k0swe/hs100b-eval/README.md

Evaluation board for the CMedia HS100B USB audio controller.
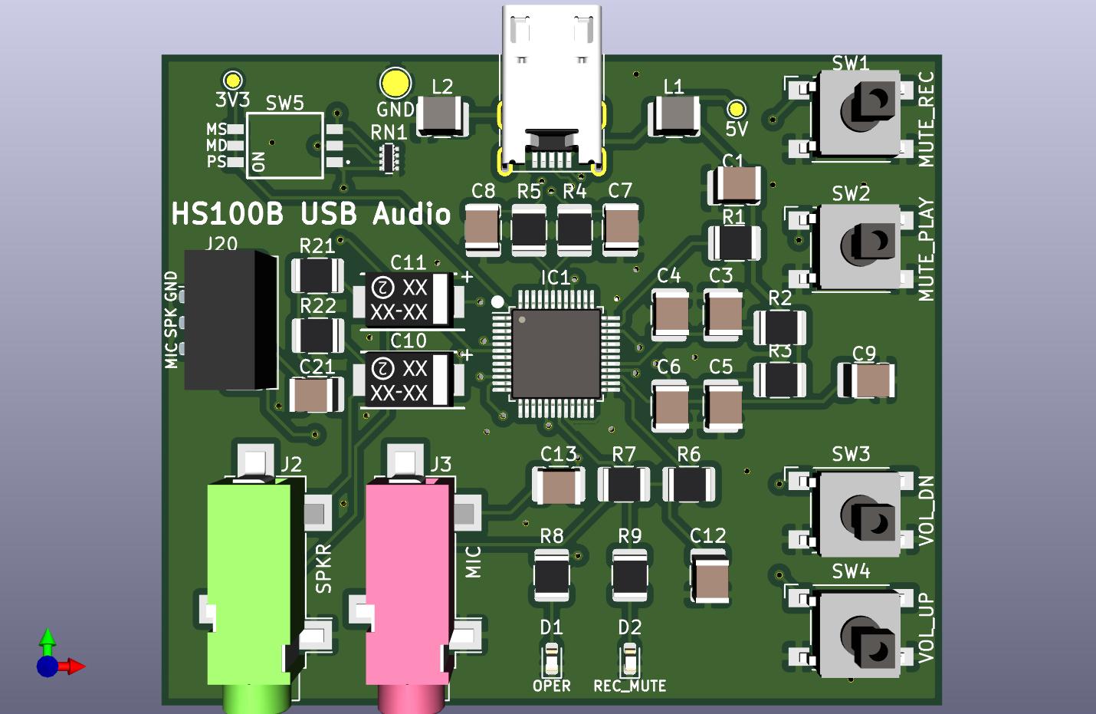
[picture p1: render.jpg]
Render
