k0swe/hs100b-eval/hs100b-eval.pdf

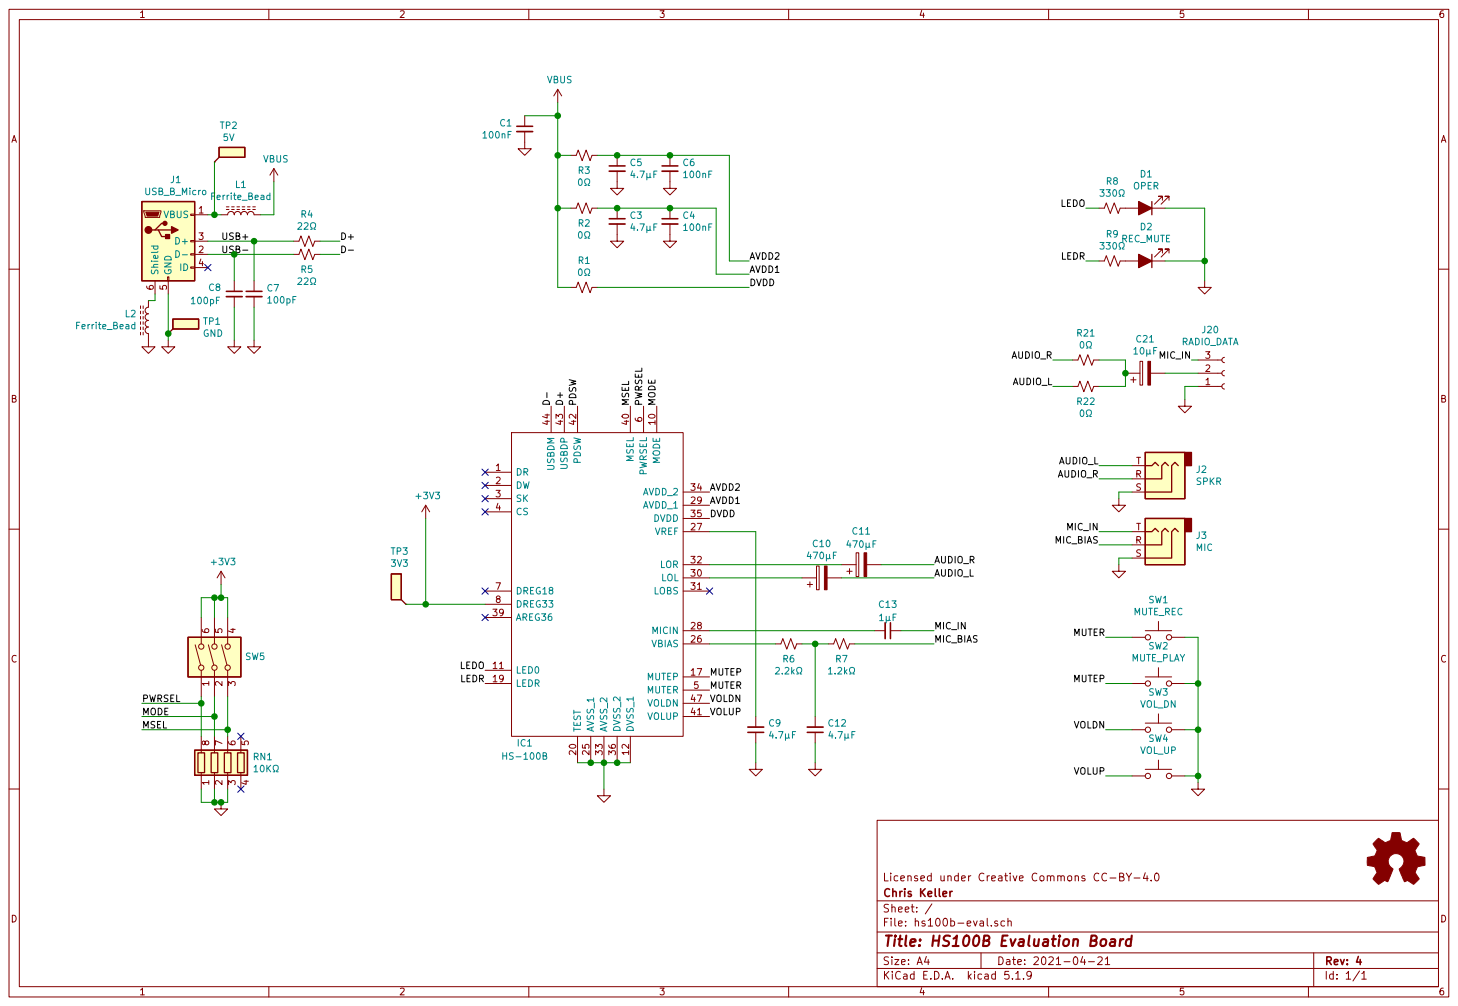
[picture p2: page 1]

File: hs100b-eval.sch Sheet: / Chris Keller Licensed under Creative Commons CC-BY-4.0 C12

Id: 1/1 Title: HS100B Evaluation Board
