k0swe/hs100b-eval/hs100b-eval.kicad_pcb

## KiCad design hs100b-eval.kicad_pcb (2021-04-24)

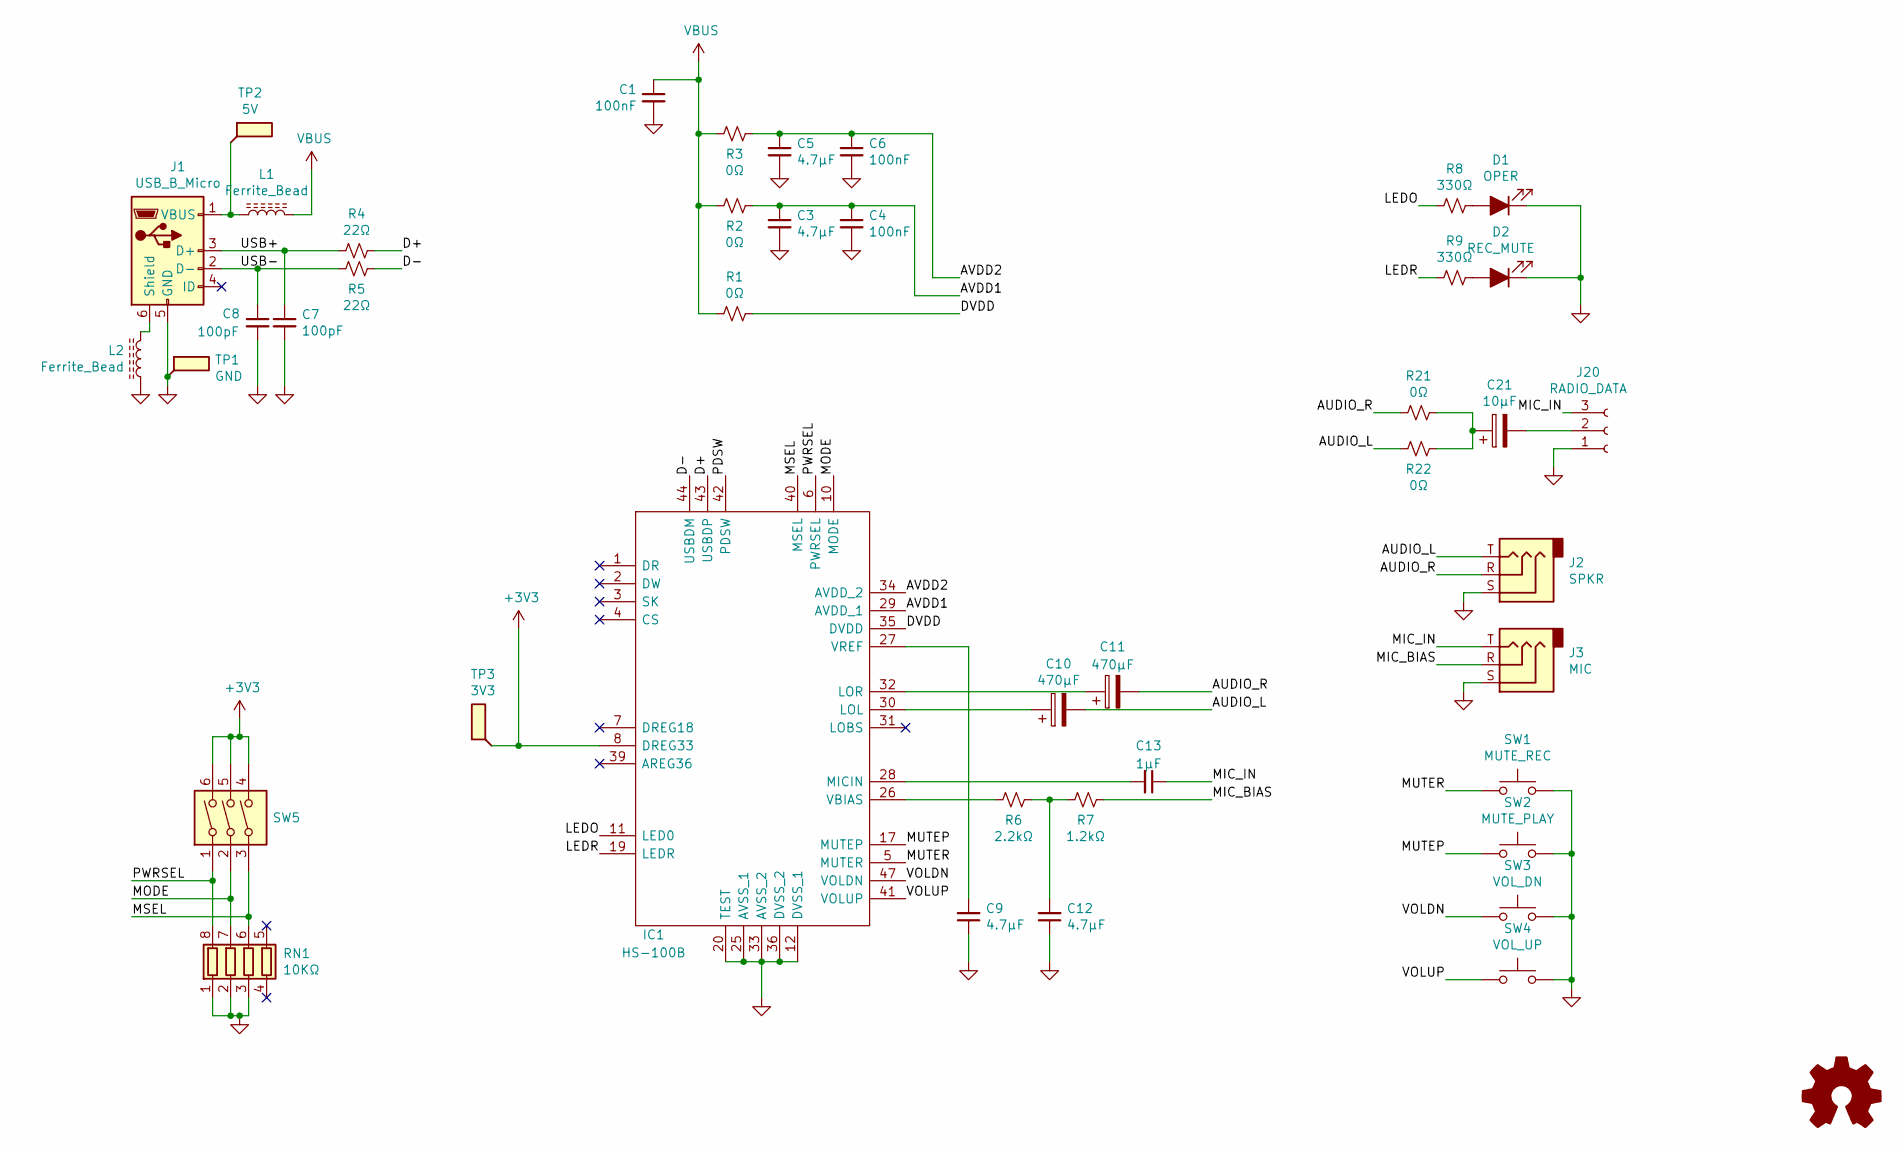
[picture p3: schematic hs100b-eval.sch, HS100B Evaluation Board]

Parts:
C1, C4, C6: 100nF; C_1210_3225Metric
C3, C5, C9, C12: 4.7μF; C_1210_3225Metric
C7, C8: 100pF; C_1210_3225Metric
C10, C11: 470μF; CAPPM7343X430N
C13: 1μF; C_1210_3225Metric
C21: 10μF; C_1210_3225Metric
D1: OPER; LED_0603_1608Metric
D2: REC_MUTE; LED_0603_1608Metric
IC1: HS-100B; LQFP-48_7x7mm_P0.5mm
J1: USB_B_Micro; UJ2-MIBH-4-SMT
J2: SPKR; Jack_3.5mm_CUI_SJ-3524-SMT_Horizontal
J3: MIC; Jack_3.5mm_CUI_SJ-3524-SMT_Horizontal
J20: RADIO_DATA; JST_PH_B3B-PH-SM4-TB_1x03-1MP_P2.00mm_Vertical
L1, L2: Ferrite_Bead; L_1210_3225Metric
LOGO1: Logo_Open_Hardware_Small; OSHW-Logo2_9.8x8mm_SilkScreen
R1, R2, R3, R21, R22: 0Ω; R_1210_3225Metric
R4, R5: 22Ω; R_1210_3225Metric
R6: 2.2kΩ; R_1210_3225Metric
R7: 1.2kΩ; R_1210_3225Metric
R8, R9: 330Ω; R_1210_3225Metric
RN1: 10KΩ; R_Array_Concave_4x0402
SW1: MUTE_REC; SW_SPST_Omron_B3FS-100xP
SW2: MUTE_PLAY; SW_SPST_Omron_B3FS-100xP
SW3: VOL_DN; SW_SPST_Omron_B3FS-100xP
SW4: VOL_UP; SW_SPST_Omron_B3FS-100xP
SW5: SW_DIP_x03; 416131160803
TP1: GND; TestPoint_Pad_D2.0mm
TP2: 5V; TestPoint_Pad_D1.0mm
TP3: 3V3; TestPoint_Pad_D1.0mm

Connections:
+3V3: IC1.8 (DREG33), SW5.4, SW5.5, SW5.6, TP3.1
/AUDIO_L: C10.2, J2.T, R22.2
/AUDIO_R: C11.2, J2.R, R21.2
/AVDD1: C3.1, C4.1, IC1.29 (AVDD_1), R2.1
/AVDD2: C5.1, C6.1, IC1.34 (AVDD_2), R3.1
/D+: IC1.43 (USBDP), R4.1
/D-: IC1.44 (USBDM), R5.1
/DVDD: IC1.35 (DVDD), R1.1
/LEDO: IC1.11 (LED0), R8.2
/LEDR: IC1.19 (LEDR), R9.2
/MIC_BIAS: J3.R, R7.1
/MIC_IN: C13.1, J3.T, J20.3
/MODE: IC1.10 (MODE), RN1.7 (R2.2), SW5.2
/MSEL: IC1.40 (MSEL), RN1.6 (R3.2), SW5.3
/MUTEP: IC1.17 (MUTEP), SW2.1
/MUTER: IC1.5 (MUTER), SW1.1
/PWRSEL: IC1.6 (PWRSEL), RN1.8 (R1.2), SW5.1
/USB+: C7.1, J1.3 (D+), R4.2
/USB-: C8.1, J1.2 (D-), R5.2
/VOLDN: IC1.47 (VOLDN), SW3.1
/VOLUP: IC1.41 (VOLUP), SW4.1
GND: C1.2, C3.2, C4.2, C5.2, C6.2, C7.2, C8.2, C9.1, C12.1, D1.1 (K), D2.1 (K), IC1.12 (DVSS_1), IC1.20 (TEST), IC1.25 (AVSS_1), IC1.33 (AVSS_2), IC1.36 (DVSS_2), J1.5 (GND), J2.S, J3.S, J20.1, L2.1, RN1.1 (R1.1), RN1.2 (R2.1), RN1.3 (R3.1), SW1.2, SW2.2, SW3.2, SW4.2, TP1.1
unnamed: C9.2, IC1.27 (VREF)
unnamed: C10.1, IC1.30 (LOL)
unnamed: C11.1, IC1.32 (LOR)
unnamed: C12.2, R6.1, R7.2
unnamed: C13.2, IC1.28 (MICIN)
unnamed: C21.1, R21.1, R22.1
unnamed: C21.2, J20.2
unnamed: D1.2 (A), R8.1
unnamed: D2.2 (A), R9.1
unnamed: IC1.26 (VBIAS), R6.2
unnamed: J1.1 (VBUS), L1.1, TP2.1
unnamed: J1.6 (Shield), L2.2
VBUS: C1.1, L1.2, R1.2, R2.2, R3.2

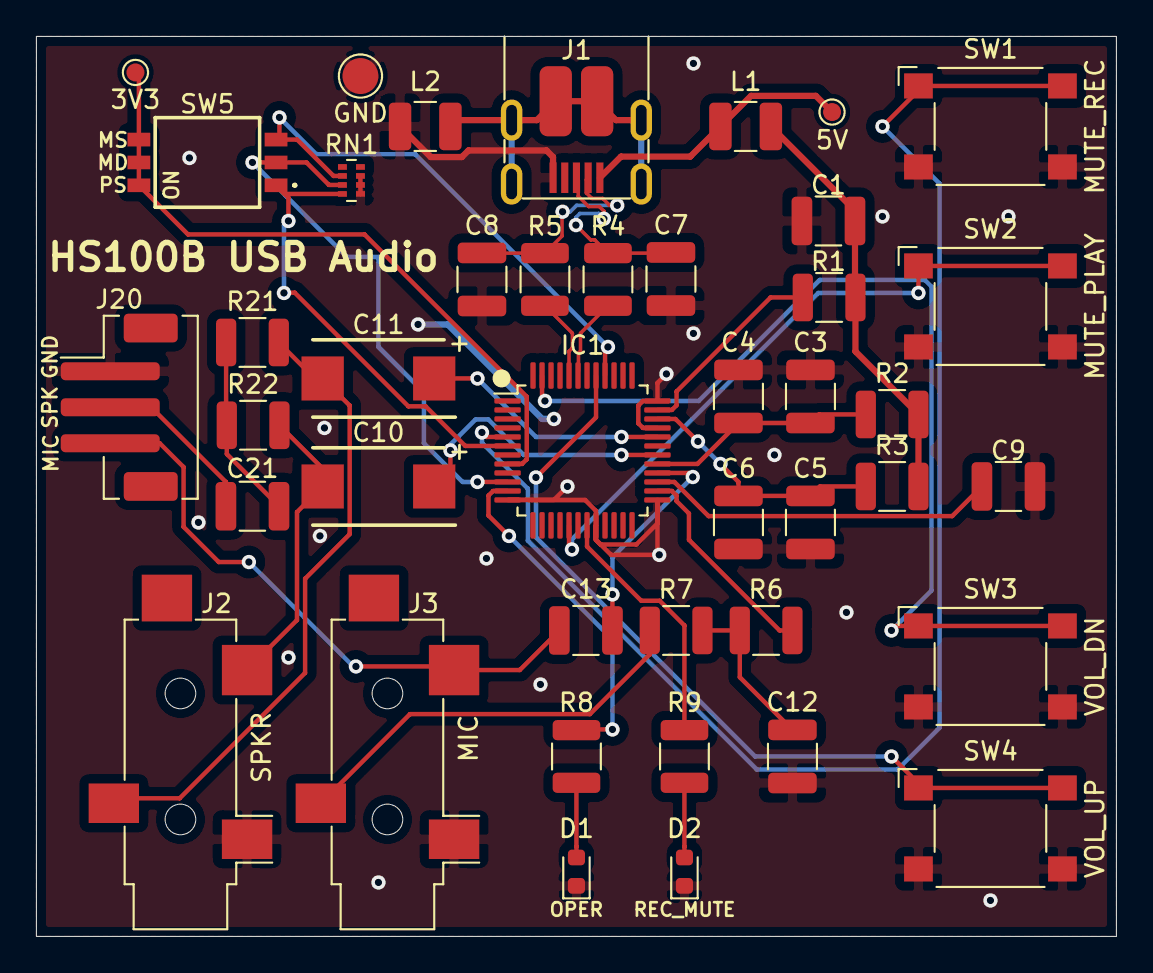
[picture p4: board hs100b-eval.kicad_pcb from above]

Board: 2 copper layers, 60.0 x 50.0 mm, 43 parts (1 on the bottom side), 35 nets.
