k0swe/hs100b-eval/(threads)

Thread 1 (2021-04-21):

Left and right audio channels reversed

xylo04, 2021-04-21:
On the 3.5 mm speaker output J1, left should be tip, right should be ring.

Closed 2021-04-21.
