k0swe/hs100b-eval/(commit log)

2021-04-06 Initial copy from CM108B eval board
    [bom.csv, hs100b-eval.kicad_pcb, hs100b-eval.sch]
2021-04-07 Add some silkscreen
    [hs100b-eval.kicad_pcb]
2021-04-14 Swap Molex micro USB for CUI
    The Molex is nearly impossible to hand solder
    [hs100b-eval.kicad_pcb, hs100b-eval.sch]
2021-04-14 Clean up libraries
    [hs100b-eval.kicad_pcb]
2021-04-14 Update BOM
    [bom.csv, hs100b-eval.kicad_pcb, hs100b-eval.sch]
2021-04-15 Add CC-BY-4.0 license
    [hs100b-eval.kicad_pcb, hs100b-eval.sch]
2021-04-15 Add CUI USB 3D model
    [hs100b-eval.kicad_pcb]
2021-04-15 Add CUI phone jack 3D models
    [hs100b-eval.kicad_pcb]
2021-04-15 Add more test points
    [hs100b-eval.kicad_pcb, hs100b-eval.sch]
2021-04-15 Move 5V test point to directly off USB
    [hs100b-eval.kicad_pcb, hs100b-eval.sch]
2021-04-18 Incorporate learnings from first physical prototype
    * Button footprint pad numberings are wrong for symbol, so they were always pressed
    * Turn J3 for solderability
    [hs100b-eval.kicad_pcb, hs100b-eval.sch]
2021-04-19 Fix up BOM
    [bom.csv]
2021-04-21 Fix R and L on J1
    Resolves #1
    [hs100b-eval.kicad_pcb, hs100b-eval.sch]
2021-04-21 Move to DIP switches for config
    [bom.csv, hs100b-eval.kicad_pcb, hs100b-eval.sch]
2021-04-21 Renumber components
    [hs100b-eval.kicad_pcb, hs100b-eval.sch]
2021-04-21 Swap Diptronics switches for smaller Wurth one
    [bom.csv, hs100b-eval.kicad_pcb, hs100b-eval.sch]
2021-04-21 Fix R and L channels
    [hs100b-eval.kicad_pcb, hs100b-eval.sch]
2021-04-24 Add OSHW logo
    [hs100b-eval.kicad_pcb, hs100b-eval.sch]
